Magicman5284/MagicPad/README.md

Welcome to the MagicPad!

This is my attempt to create a smarthome control device. 
Recently I've made a couple smart devices controlled by esp32s, so I wanted to make a device that could control them. 
The two devices it's set up to control right now are my coffee maker and my alarm clock. 
Because these are both custom projects, I don't see the MagicPad's current firmware being useful to anyone else, but that hardware can be used to control any device that can be controlled over wifi!
Because of how versatile the hardware is, it has plenty of room for future expansion such as adding games!

Assembly:
- Pretty self-explanatory for the most part, just solder the components where they are in the 3d model. 
- The one tricky part is the battery.
- To connect the battery, solder the negative wire from the battery holder into the hole in the board to the right of the buttons. 
- After this, directly solder the positive wire to the positive pin on the battery connector of the ESP32. 
- To determine which one a the positive pin, a multimeter on beeper mode can be used between both pins and ground. if it beeps, that pin is negative. 
- You also might need some additional dupont connectors to raise the screen up so it's not swallowed by the case

  Useage:
- I think the UI is pretty self-explanatory and probably no one else is ever gonna use it, so I'm not gonna bother explaining it. 
- The switch in the bottom right is a power switch
- I know this is bad design, but the device needs to be powered ON in order for it to charge. 
- Bottom left button is a back button and top right is a home button. 
- You need to input wifi and IP information in the sketch before you upload it

BOM:
| Item | Qty | Supplier | Cost/item | Total Cost | link |
|---|-----|---|---|---|---|
| 2.4 in tft screen | 1 | Aliexpress | $3.85 | $3.85 | https://www.aliexpress.us/item/3256808368541153.html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 |
| ESP32-S Development Board 2.4G Wifi Module with Battery Interface Original Ai ESP32-S for DIY IoT CH340X IP5306 Type | 1 | Aliexpress | $6.32 | $6.32 | https://www.aliexpress.us/item/3256808312600406.html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 |
| 18650 battery holder | 1 | Aliexpress | $0.99 | $0.99 | https://www.aliexpress.us/item/2251832638846318.html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 |
| 18650 battery | 1 | 18650 battery store | $4.99 | $4.99 | https://www.18650batterystore.com/products/samsung-25r-18650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 |
| minitoggle switch 3 prongs | 1 | Aliexpress | $3.82 | $3.82 | https://www.aliexpress.us/item/3256808118023831.html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 |
| EC11 rotary encoder with push button | 1 | Aliexpress | $1.37 | $1.37 | https://www.aliexpress.us/item/3256807457768762.html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 |
| 10k resistor | 1 | Aliexpress | $1.53 | $1.53 | https://www.aliexpress.us/item/3256809143779506.html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 |
| 1x10 dupont connectors | 1 | Aliexpress | $2.83 | $2.83 | https://www.aliexpress.us/item/3256811876826434.html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 |
| 1x4 dupont connectors | 1 | Aliexpress | $2.37 | $2.37 | https://www.aliexpress.us/item/3256811876826434.html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 |
| Cherry mx swicthes | 1 | Aliexpress | $3.69 | $3.69 | https://www.aliexpress.us/item/3256812387735845.html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 |
| keycaps | 1 | Aliexpress | $2.02 | $2.02 | https://www.aliexpress.us/item/3256813177462628.html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 |
| PCB | 1 | JLCPCB | $20.08 | $20.08 | https://jlcpcb.com/ |
| Estimated total shipping | 1 | | | $0.00 | |
