Magicman5284/MagicPad/BOM.csv

Item | Qty | Supplier | Cost/item | Total Cost | link
2.4 in tft screen | 1 | Aliexpress | $3.85 | $3.85 | https://www.aliexpress.us/item/3256808368541153.html?curPageLogUid=2lMKeavTadMR
ESP32-S Development Board 2.4G Wifi Module with Battery Interface Original Ai ESP32-S for DIY IoT CH340X IP5306 Type | 1 | Aliexpress | $6.32 | $6.32 | https://www.aliexpress.us/item/3256808312600406.html?mp=1
18650 battery holder | 1 | Aliexpress | $0.99 | $0.99 | https://www.aliexpress.us/item/2251832638846318.html?mp=1
18650 battery | 1 | 18650 battery store | $4.99 | $4.99 | https://www.18650batterystore.com/products/samsung-25r-18650?variant=37119890063511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
minitoggle switch 3 prongs | 1 | Aliexpress | $3.82 | $3.82 | https://www.aliexpress.us/item/3256808118023831.html?curPageLogUid=bxfWoncg7wrM
EC11 rotary encoder with push button | 1 | Aliexpress | $1.37 | $1.37 | https://www.aliexpress.us/item/3256807457768762.html?curPageLogUid=uPza42i6Mwl9
10k resistor | 1 | Aliexpress | $1.53 | $1.53 | https://www.aliexpress.us/item/3256809143779506.html?curPageLogUid=K5N1yOKL6CDi
1x10 dupont connectors | 1 | Aliexpress | $2.83 | $2.83 | https://www.aliexpress.us/item/3256811876826434.html?mp=1
1x4 dupont connectors | 1 | Aliexpress | $2.37 | $2.37 | https://www.aliexpress.us/item/3256811876826434.html?mp=1
Cherry mx swicthes | 1 | Aliexpress | $3.69 | $3.69 | https://www.aliexpress.us/item/3256812387735845.html?curPageLogUid=uhg1IY7N6ELF
keycaps | 1 | Aliexpress | $2.02 | $2.02 | https://www.aliexpress.us/item/3256813177462628.html?curPageLogUid=Vra1xloKuPlE
PCB | 1 | JLCPCB | $20.08 | $20.08 | https://jlcpcb.com/
Estimated total shipping | 1 |  |  | $0.00
