Magicman5284/MagicPad/MagicPad_top.stl

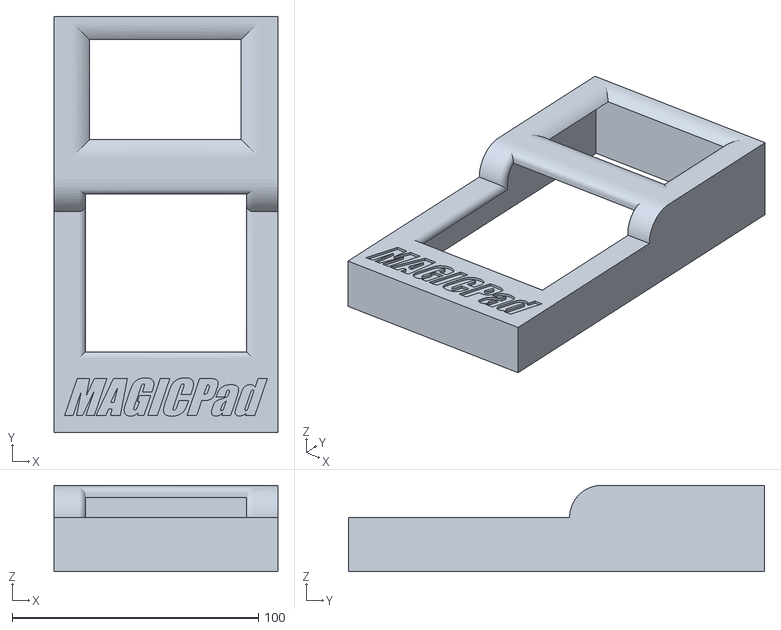
[picture p1: CAD file, 2026-11-07]
MagicPad_top.stl
90.8 x 168.8 x 35.0
