Magicman5284/MagicPad/MagicPad_case.step

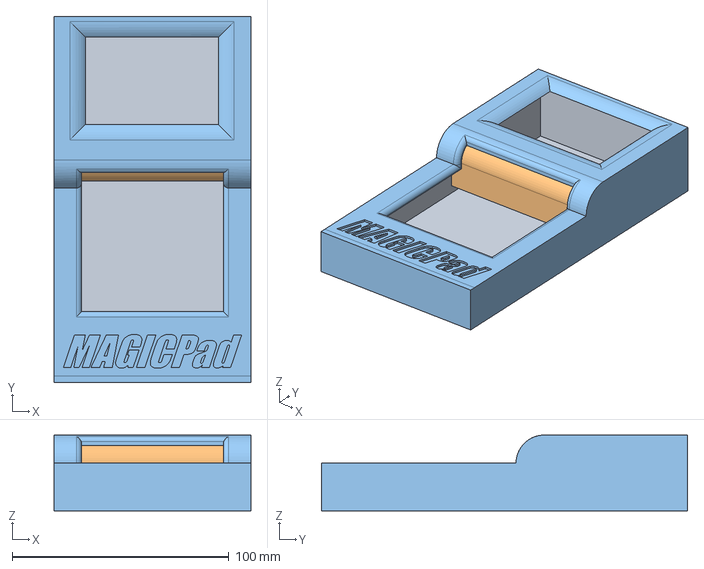
[picture p2: CAD file, 2026-11-07]
MagicPad_case.step
90.8 x 168.8 x 35.0 mm
