Magicman5284/MagicPad/MagicPad_bottom.stl

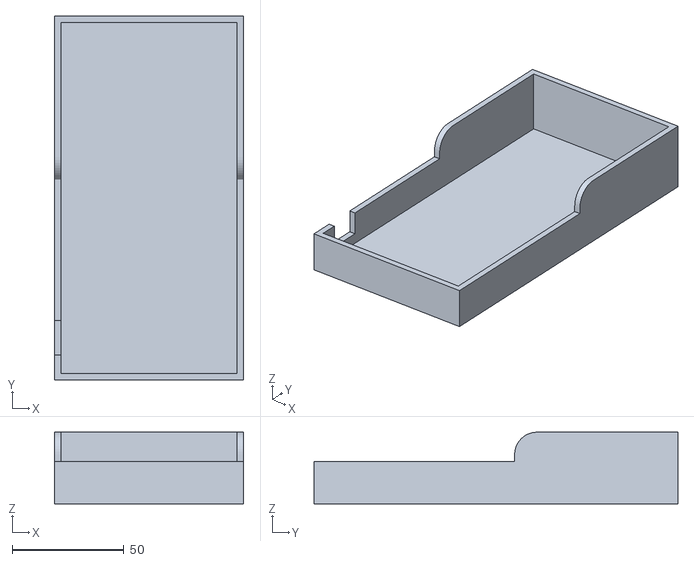
[picture p3: CAD file, 2026-11-07]
MagicPad_bottom.stl
84.5 x 162.5 x 32.0
