Magicman5284/MagicPad/MagicPad_PCB_3d_model.step

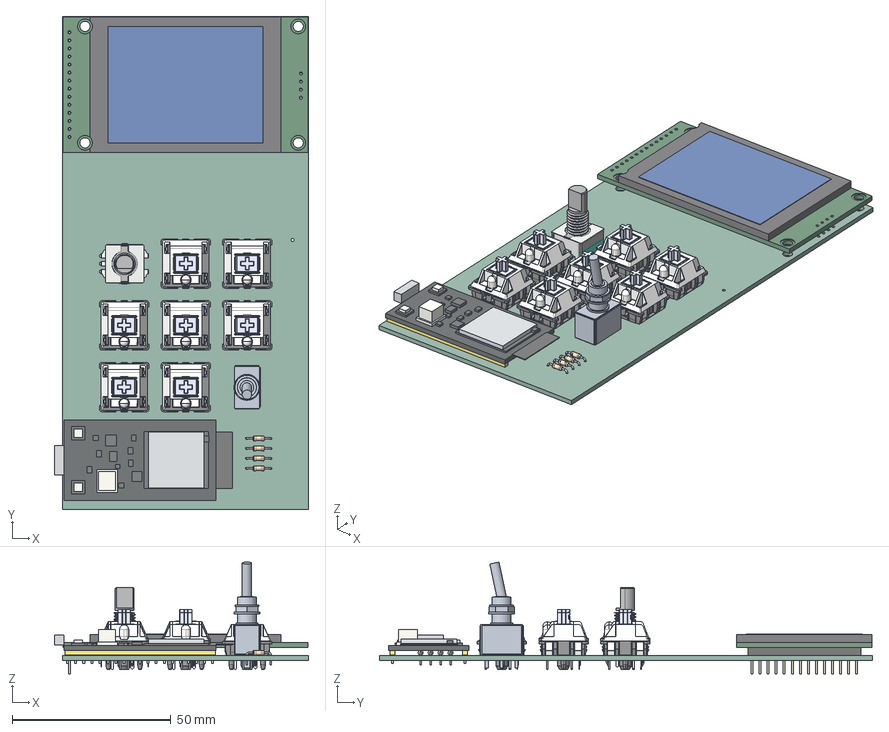
[picture p4: CAD file, 2026-11-07]
MagicPad_PCB_3d_model.step
80.1 x 155.5 x 35.3 mm
Bottom x 7
Pulsador x 7
Top x 7
Pieza5^Cherry MX x 7
Pin1 x 7
Pin2 x 7
Led 3mm_trans x 7
PCB_42.72x77.18x1.60
LCD_Backlight_Housing
LCD_Active_Area_36.72x48.96
14pin_Header_Housing_Approx
Header_Pin_1
Header_Pin_2
Header_Pin_3
Header_Pin_4
Header_Pin_5
Header_Pin_6
Header_Pin_7
Header_Pin_8
Header_Pin_9
Header_Pin_10
Header_Pin_11
Header_Pin_12
Header_Pin_13
Header_Pin_14
R_Axial_DIN0204_L36mm_D16mm_P762mm_Horizontal x 4
FR4_board_0
Header_spacer_1
Header_spacer_2
Header_pin_1_3
Header_pin_2_4
Header_pin_3_5
Header_pin_4_6
Header_pin_5_7
Header_pin_6_8
Header_pin_7_9
Header_pin_8_10
Header_pin_9_11
Header_pin_10_12
Header_pin_11_13
Header_pin_12_14
Header_pin_13_15
Header_pin_14_16
Header_pin_15_17
Header_pin_16_18
Header_pin_17_19
Header_pin_18_20
Header_pin_19_21
Header_pin_38_22
Header_pin_37_23
Header_pin_36_24
Header_pin_35_25
Header_pin_34_26
Header_pin_33_27
Header_pin_32_28
Header_pin_31_29
Header_pin_30_30
Header_pin_29_31
Header_pin_28_32
Header_pin_27_33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
