Magicman5284/MagicPad/(list of files, cad)

Other CAD files:
MagicPad_case.f3d
