Magicman5284/MagicPad/MagicPad.kicad_pcb

## KiCad design MagicPad.kicad_pcb (2026-11-07)

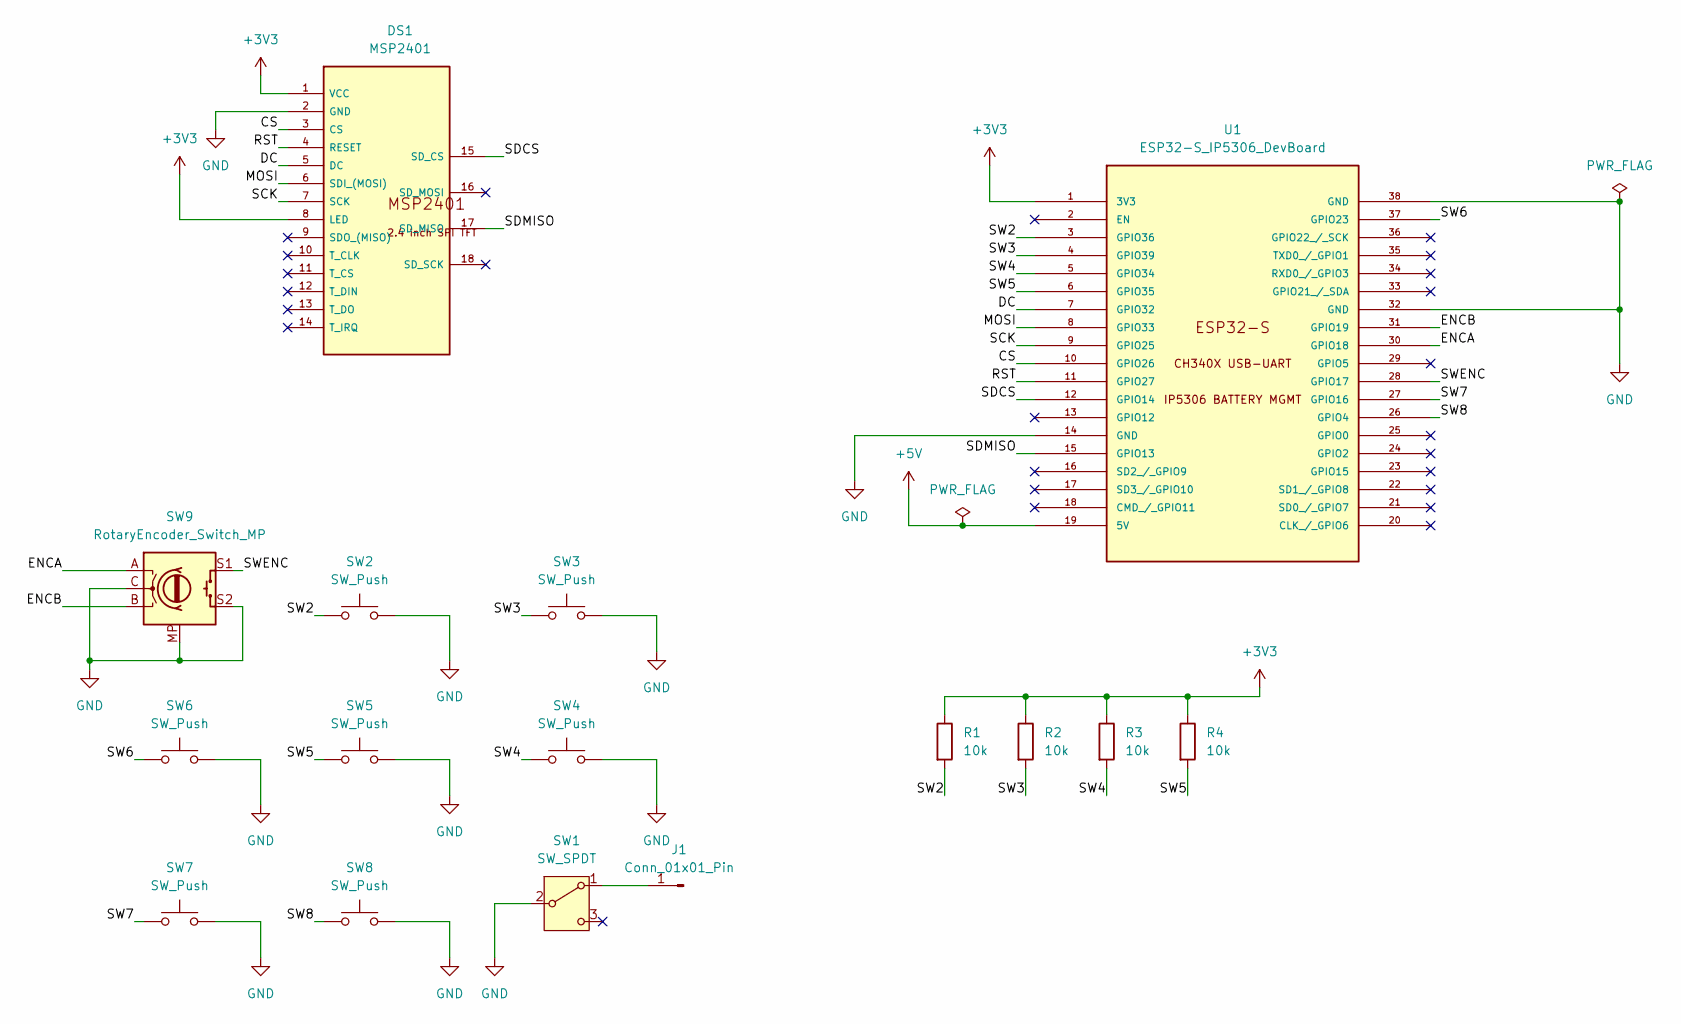
[picture p5: schematic MagicPad.kicad_sch]

Parts:
DS1: MSP2401
J1: Conn_01x01_Pin; PinHeader_1x01_P2.54mm_Vertical
R1, R2, R3, R4: 10k; R_Axial_DIN0204_L3.6mm_D1.6mm_P7.62mm_Horizontal
SW1: SW_SPDT; MiniToggle_SPDT_3Lug
SW2, SW3, SW4, SW5, SW6, SW7, SW8: SW_Push; SW_Cherry_MX_1.00u_PCB
SW9: RotaryEncoder_Switch_MP; RotaryEncoder_Alps_EC11E-Switch_Vertical_H20mm
U1: ESP32-S_IP5306_DevBoard; ESP32S_IP5306

Connections:
+3V3: DS1.1 (VCC), DS1.8 (LED), R1.1, R2.1, R3.1, R4.1, U1.1 (3V3)
+5V: U1.19 (5V)
/CS: DS1.3 (CS), U1.10 (GPIO26)
/DC: DS1.5 (DC), U1.7 (GPIO32)
/ENCA: SW9.A, U1.30 (GPIO18)
/ENCB: SW9.B, U1.31 (GPIO19)
/MOSI: DS1.6 (SDI_(MOSI)), U1.8 (GPIO33)
/RST: DS1.4 (RESET), U1.11 (GPIO27)
/SCK: DS1.7 (SCK), U1.9 (GPIO25)
/SDCS: DS1.15 (SD_CS), U1.12 (GPIO14)
/SDMISO: DS1.17 (SD_MISO), U1.15 (GPIO13)
/SW2: R1.2, SW2.1, U1.3 (GPIO36)
/SW3: R2.2, SW3.1, U1.4 (GPIO39)
/SW4: R3.2, SW4.1, U1.5 (GPIO34)
/SW5: R4.2, SW5.1, U1.6 (GPIO35)
/SW6: SW6.1, U1.37 (GPIO23)
/SW7: SW7.1, U1.27 (GPIO16)
/SW8: SW8.1, U1.26 (GPIO4)
/SWENC: SW9.S1, U1.28 (GPIO17)
GND: DS1.2 (GND), SW1.2 (B), SW2.2, SW3.2, SW4.2, SW5.2, SW6.2, SW7.2, SW8.2, SW9.C, SW9.MP, SW9.S2, U1.14 (GND), U1.32 (GND), U1.38 (GND)
unnamed: J1.1 (Pin_1_1), SW1.1 (A)

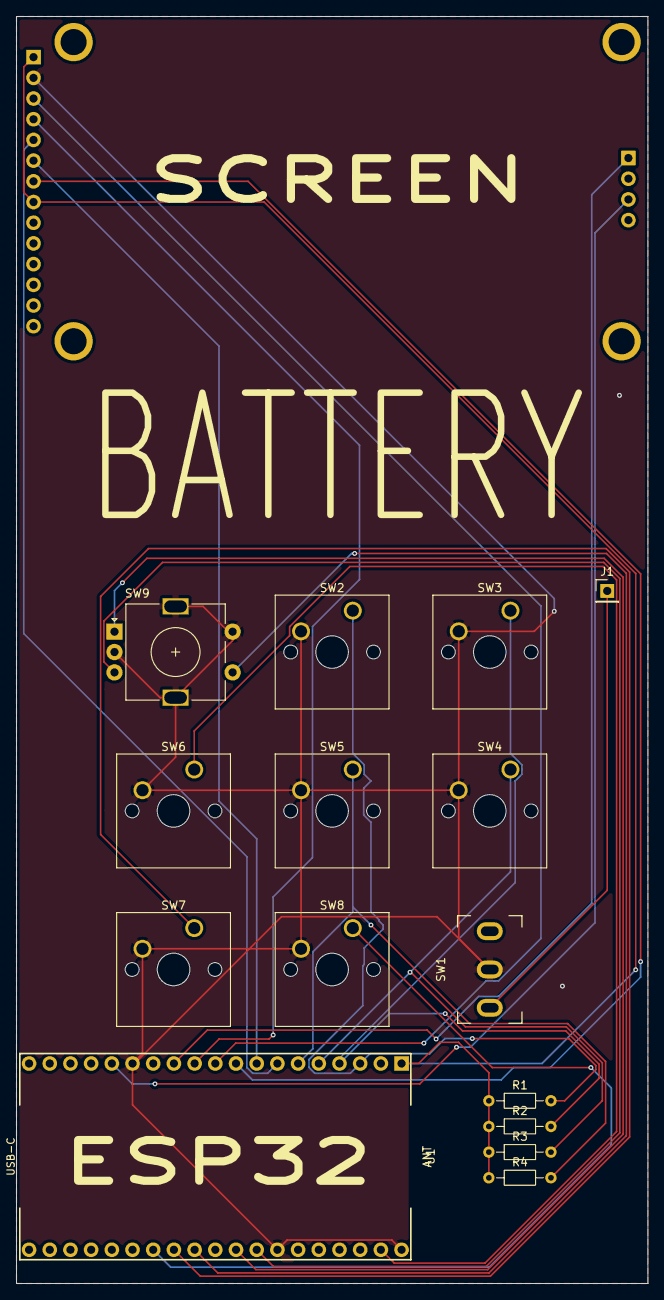
[picture p6: board MagicPad.kicad_pcb from above]

Board: 2 copper layers, 77.5 x 155.5 mm, 16 parts (0 on the bottom side), 20 nets.
