Magicman5284/MagicPad/(commit log)

2026-11-06 Sync MagicPad from Half Life
    [BOM.csv]
2026-11-07 Added Kicad files
    [MagicPad.kicad_pcb, MagicPad.kicad_sch, MagicPad_PCB_3d_model.step]
2026-11-07 Added files for the case
    includes fusion design files, step files, and an stl for both pieces
    [MagicPad_bottom.stl, MagicPad_case.f3d, MagicPad_case.step, MagicPad_top.stl]
2026-11-07 Add README with project details and assembly instructions
    Added detailed project description, assembly instructions, usage guidelines, and bill of materials (BOM) for the MagicPad smarthome control device.
2026-11-07 Added Kicad files
    swapping out the old kicad files because I realized that I had the GND pour zone filled underneath the ESP32 antenna. These files contain the fix for this.
    [MagicPad.kicad_pcb, MagicPad.kicad_sch]
